Hikarinaka/DKLed/BOM_DKLed-V0.95_2025-02-23.csv

ID | Name | Designator | Footprint | Quantity | Manufacturer Part | Manufacturer | Supplier | Supplier Part | Price | Pins | 3DModel | value
1 | TF-HOLDER | SD1 | TF-PULL | 1 |  |  |  |  |  | 13 | sd | TF-HOLDER
2 | btn4 | JP35,JP21 | 1X01 | 2 |  |  |  |  |  | 1 |  | btn4
3 | 47k | R13,R4,R5,R6,R7 | R0805 | 5 | 0805W8F4702T5E | UniOhm | LCSC | C17713 | 0.002 | 2 | R0805_L2.0-W1.3-H0.6 | 47k
4 | Power supply | JP6 | 1X05 | 1 |  |  |  |  |  | 5 | PinHeader_1x02_P2.54mm_Vertical | Power supply
5 | STM32F103C8T6 | U$1 | LQFP-48 | 1 | STM32F103C8T6 | STMicroelectronics | LCSC | C8734 | 1.162 | 48 | STM32F103C8T6/3D/STM32F103C8T6 COPY | STM32F103C8T6
6 | CSTCE8M00G55A | Q1 | CSTCE_G_A | 1 | CSTNE8M00G55Z000R0 | Murata Electronics | LCSC | C341524 | 0.267 | 3 | CSTCE | CSTCE8M00G55A
7 | TPS76333DBVR | U1 | SOT23-5 | 1 | TPS76333DBVR | TI | LCSC | C7100 | 0.362 | 5 | sot23-5 | TPS76333DBVR
8 | 10mk | C4,C5 | C0805 | 2 | CL21A106KAYNNNE | SAMSUNG | LCSC | C15850 | 0.009 | 2 | C0805_L2.0-W1.3-H1.3 | 10mk
9 | 100n | C3,C6,C7 | C0603 | 3 | CC0603ZRY5V9BB104 | YAGEO | LCSC | C106221 | 0.003 | 2 | C0603_L1.6-W0.8-H0.8 | 100n
10 | 100k | R1,R2 | R0805 | 2 | 0805W8F1003T5E | UniOhm | LCSC | C17407 |  | 2 | R0805_L2.0-W1.3-H0.6 | 100k
11 | USBPCB | X2 | USB-A-PCB | 1 |  |  |  |  |  | 4 |  | USBPCB
12 | UART12 | JP1 | 2X04 | 1 |  |  |  |  |  | 8 | PinHeader_2x04_P2.54mm_Vertical | UART12
13 | 22 | R10,R12 | R0805 | 2 | 0805W8F220JT5E | UniOhm | LCSC | C17561 | 0.002 | 2 | R0805_L2.0-W1.3-H0.6 | 22
14 | 1,5k | R11 | R0805 | 1 | 0805W8F1801T5E | UniOhm | LCSC | C17398 | 0.002 | 2 | R0805_L2.0-W1.3-H0.6 | 1,5k
15 | ws1 | JP4 | 1X01 | 1 |  |  |  |  |  | 1 |  | ws1
16 | ws0 | JP9 | 1X01 | 1 |  |  |  |  |  | 1 |  | ws0
17 | ws3 | JP11 | 1X01 | 1 |  |  |  |  |  | 1 |  | ws3
18 | ws2 | JP14 | 1X01 | 1 |  |  |  |  |  | 1 |  | ws2
19 | ws4 | JP19 | 1X01 | 1 |  |  |  |  |  | 1 |  | ws4
20 | ws5 | JP20 | 1X01 | 1 |  |  |  |  |  | 1 |  | ws5
21 | Prog pwr3 | JP29 | 1X01 | 1 |  |  |  |  |  | 1 |  | Prog pwr3
22 | prog swdio | JP30 | 1X01 | 1 |  |  |  |  |  | 1 |  | prog swdio
23 | prog swclk | JP31 | 1X01 | 1 |  |  |  |  |  | 1 |  | prog swclk
24 | prog gnd | JP32 | 1X01 | 1 |  |  |  |  |  | 1 |  | prog gnd
25 | btn gnd | JP22 | 1X01 | 1 |  |  |  |  |  | 1 | PinHeader_1x06_P2.54mm_Vertical | btn gnd
26 | btn3 | JP23 | 1X01 | 1 |  |  |  |  |  | 1 |  | btn3
27 | btn2 | JP24 | 1X01 | 1 |  |  |  |  |  | 1 |  | btn2
28 | btn1 | JP25 | 1X01 | 1 |  |  |  |  |  | 1 |  | btn1
29 | gnd | JP2,JP26 | 1X01 | 2 |  |  |  |  |  | 1 |  | gnd
30 | pwr5 | JP27,JP28 | 1X01 | 2 |  |  |  |  |  | 1 |  | pwr5
31 | ws7 | JP33,JP34 | 1X01 | 2 |  |  |  |  |  | 1 |  | ws1
