Hikarinaka/DKLed/DKLed_I5O8U2_v0.95-copy_2025-02-23.dxf

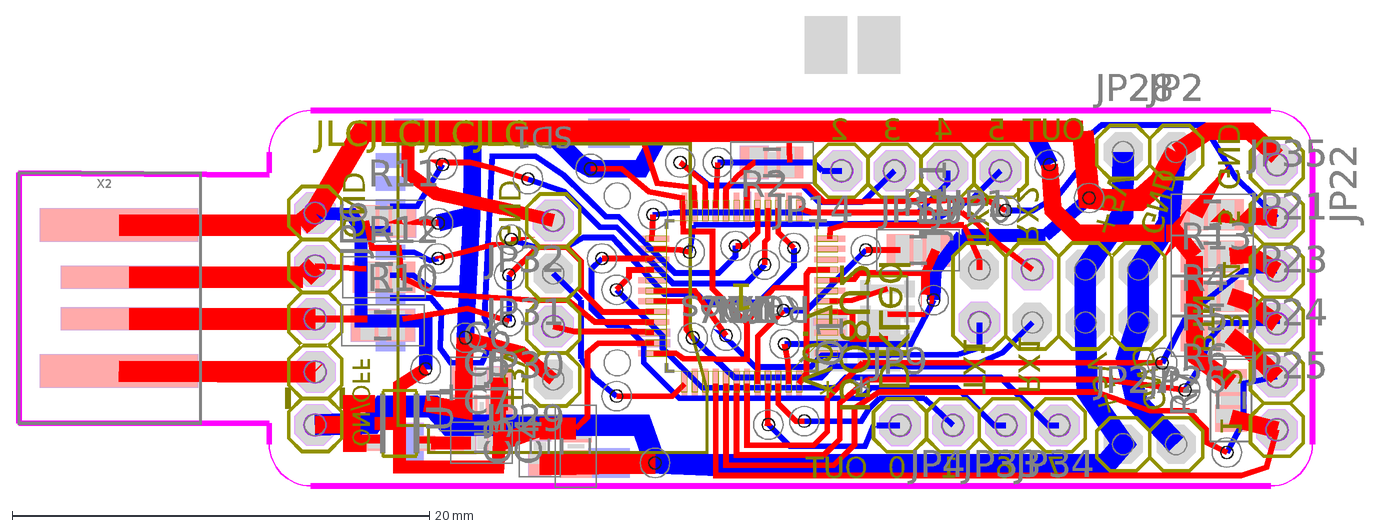
[picture p5: CAD file, 2025-07-04]
DKLed_I5O8U2_v0.95-copy_2025-02-23.dxf
DKLed
GND
ON/OFF
RX1
+5V
TX1
TX2
BTN
OUT
RX2
+3V
2
3
4
0
1
5
V0.7
I5O8U2
6
7
JLCJLCJLCJLC
SD1
JP35
R13
JP6
*
RefDes
DEV
PN
VAL
TOL
Q1
U1
C4
C5
C3
C6
C7
R1
R2
X2
JP1
R4
R5
R6
R7
R10
R11
R12
JP4
JP9
JP11
JP14
JP19
JP20
JP29
JP30
JP31
JP32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
