Hikarinaka/DKLed/Schematic_DKLed-V0.95_2025-02-23.pdf

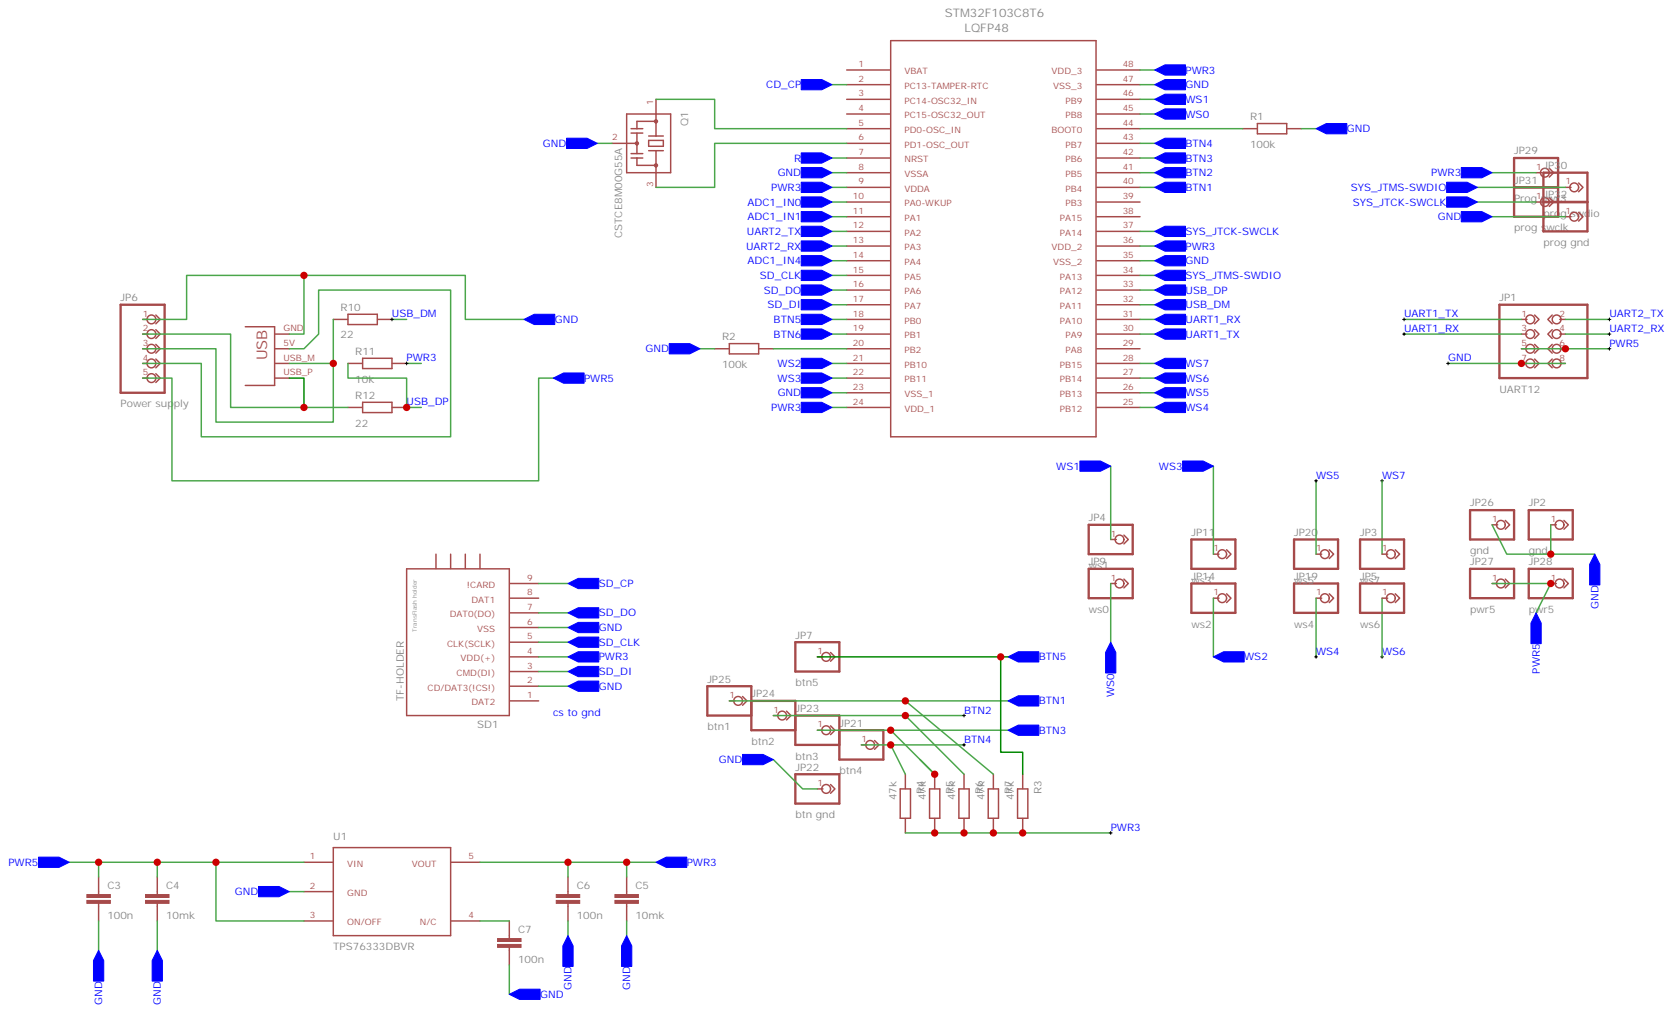
[picture p6: page 1]
