Hikarinaka/DKLed/(list of files, drawings)

Other design files:
DKLed_I5O8U2_v0.95-EasyEDA_JLCPcb_copy_2025-02-23.json
Sheet_1-copy_2025-02-23.schdoc
